samuelitorojas12-arch/Carrito-S.L.26/Pruebas de Funcionamiento/2.jpeg

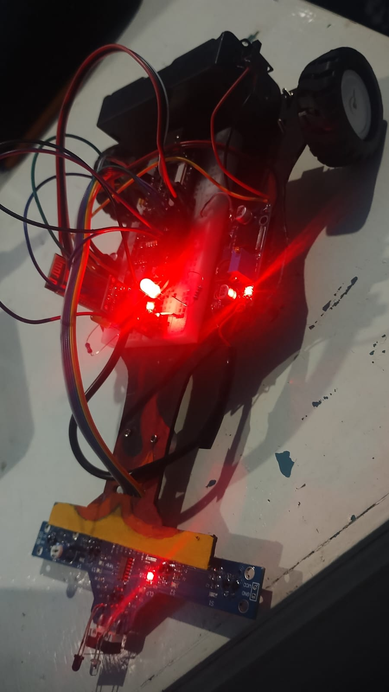
Pruebas de Funcionamiento/2.jpeg
