samuelitorojas12-arch/Carrito-S.L.26/doc/REPORTE_UNIVERSITARIO.md

# Reporte Técnico: Controlador Digital de Seguidor de Línea Competitivo con FPGA Tang Nano 9K
**Curso: Programacion Avanzada / Diseño con FPGAs**  
**Departamento de Ingeniería Electrónica - Universidad Veracruzana**

---

## Resumen
Este informe presenta el diseño, la implementación y la verificación de un controlador digital modular síncrono para un robot móvil seguidor de línea de alto rendimiento, desarrollado para participar en la **“2.ª Carrera de Carritos Seguidores de Línea 2026”**. El proyecto fue posteriormente optimizado y mejorado a partir de observaciones, comentarios y propuestas de mejora realizadas por el docente responsable, con el objetivo de incrementar su funcionalidad, robustez y desempeño general.

El sistema fue implementado en hardware sobre la FPGA **Tang Nano 9K (GW1NR-LV9QN88PC6/I5)** e integra diversas funcionalidades avanzadas, entre las que destacan una estrategia de arranque autónomo mediante sensor de luz (LDR) con inmunidad al ruido, control de velocidad de motores mediante modulación por ancho de pulso (PWM) a 20 kHz y la incorporación de un módulo de comunicación Bluetooth **HC-05**, capaz de transmitir y recibir información para la interacción y supervisión del usuario.

Asimismo, se implementó un algoritmo de recuperación inteligente basado en memoria de dirección, diseñado para permitir que el vehículo retome la trayectoria en caso de pérdida temporal del contraste de la pista. Como medida adicional de seguridad, el sistema incorpora un mecanismo de detención automática de dos segundos ante determinadas condiciones de operación.

La síntesis lógica y el ruteo físico del diseño fueron realizados mediante la herramienta **Gowin EDA**, obteniéndose un resultado final libre de errores y advertencias. Para alcanzar este nivel de estabilidad fue necesario aplicar restricciones temporales mediante archivos **.sdc**, así como resolver conflictos de asignación de voltaje en los bancos lógicos de la FPGA, garantizando así el correcto funcionamiento y la confiabilidad del sistema implementado.

---

## 1. Introducción y Cumplimiento del Reglamento

El diseño de un vehículo robótico seguidor de línea de competencia (modalidad carrera de alcance) requiere maximizar la velocidad promedio en rectas y la estabilidad en curvas, garantizando a su vez el estricto cumplimiento de las normas oficiales establecidas en el reglamento:

1.  **Arranque Autónomo Obligatorio:** El reglamento prohíbe cualquier movimiento del carro antes del destello de la luz LED blanca de inicio. Para cumplir esto, el sistema integra un sensor óptico frontal (fotoresistencia LDR acoplada a un comparador LM393) que actúa como llave de encendido. La FPGA filtra y valida esta señal física en un módulo digital exclusivo para evitar descalificaciones por salidas en falso.
2.  **Dimensiones Máximas (24 cm de largo, 20 cm de ancho):** El chasis de tracción diferencial cuenta con unas dimensiones de $18\text{ cm} \times 14\text{ cm}$, lo que cumple cómodamente con la regla y optimiza el momento de inercia rotacional en curvas cerradas.
3.  **Algoritmo de Recuperación en Pista (Línea Perdida):** Ante salidas totales de la línea negra de 2 cm de ancho, el carro dispone de 10 segundos reglamentarios para reincorporarse de forma autónoma. El controlador de la FPGA memoriza la última corrección válida de los sensores infrarrojos e inicia una rotación de pivote (motores opuestos) en la misma dirección de escape para re-detectar la trayectoria. Si tras 2 segundos de búsqueda no se detecta la pista, el sistema se detiene automáticamente por seguridad.

---

## 2. Arquitectura Electrónica y Modular

### C. Módulo Bluetooth HC-05 (arranque_bt.v)

Este módulo monitorea continuamente los datos válidos recibidos desde el receptor UART. Cuando detecta la recepción del carácter ASCII **'1'** (valor hexadecimal **0x31**), genera y activa la señal **start_flag_bt**, la cual funciona como una bandera de inicio del sistema. Una vez activada, esta señal permanece enclavada (estado lógico alto) de manera indefinida, permitiendo indicar que se ha recibido la orden de arranque. La bandera únicamente puede ser desactivada mediante una señal de **reset**, garantizando así la persistencia del comando de inicio hasta que el sistema sea reiniciado.

```
[Entradas]                            [Núcleo de Procesamiento FPGA]                            [Salidas]
  CLK (52)  -----------------------> [  filtro_arranque  ]                                   
  LDR (33)  ----------------------->      |                                                  
                                          v (start_flag)                                     
  S1...S5   -----------------------> [  seguidor_linea_core ] ----------------------------->  Dirección Motores
  (28...32)                               |                                                   (34 y 35)
                                          v (duty_cycle)                                     
                                     [  controlador_pwm   ] ----------------------------->  Velocidad Motores (PWM)
                                                                                              (10 y 11)
```

### A. Filtro del Sensor de Arranque LDR (`filtro_arranque.v`)
La señal entregada por el comparador LM393 del LDR puede contener oscilaciones y transitorios causados por la luz ambiental o el encendido de flashes en la pista. El módulo de arranque implementa un contador digital de histéresis temporal. Requiere que la entrada `LDR_IN` se mantenga en nivel alto de forma ininterrumpida por al menos 10 ms ($270,000$ ciclos a 27 MHz) antes de activar la bandera `start_flag`. Una vez activada, la señal se enclava de forma irreversible en `1` hasta que ocurra un reset físico de la tarjeta, evitando que las sombras generadas por el propio carro durante la carrera afecten la marcha.

### B. Controlador PWM de Frecuencia Portadora (`controlador_pwm.v`)
El control continuo de velocidad de los micromotores N20 se realiza mediante Modulación por Ancho de Pulso (PWM). El módulo implementa dos generadores de rampa de 8 bits (resolución de 0 a 255). A partir de la frecuencia de reloj del sistema, se introduce un prescaler divisor entre 5 que disminuye la base de tiempos a un periodo de rampa de $48.3\ \mu\text{s}$, lo que equivale a una frecuencia portadora de **20.7 kHz**. Esta frecuencia ultrasónica es ideal para pequeños servomotores y motores DC metálicos: elimina por completo el molesto silbido mecánico audible en los bobinados y reduce de forma significativa las corrientes de rizado y disipación térmica en el chip driver (TB6612FNG).

 ### C. Módulo Bluetooth HC-05 (arranque_bt.v)

Este módulo se encarga de supervisar los datos recibidos y validados por el receptor UART proveniente del módulo Bluetooth HC-05. Cuando detecta la recepción del carácter ASCII **'1'** (código hexadecimal **0x31**), activa la señal **start_flag_bt**, la cual indica el inicio de la operación del sistema. Una vez establecida, esta bandera permanece activa de forma permanente mediante un mecanismo de enclavamiento, evitando que se pierda la orden de arranque. La señal únicamente se restablece a su estado inicial cuando se ejecuta un reinicio (reset) del sistema.

### D. Núcleo de Control y Recuperación (`seguidor_linea_core.v`)
El núcleo implementa la máquina de control de velocidad y sentido de giro, traduciendo los estados de los sensores infrarrojos reflectantes ($S_1$ a $S_5$) en salidas de potencia de acuerdo con la tabla de verdad y la estrategia de control competitiva:
*   **Marcha Recta (`00100`):** Máxima potencia hacia ambos motores (`VEL_MAX = 225`) en sentido directo para recortar distancias en tramos lineales.
*   **Curvas Suaves (`01100` y `00110`):** Se desacelera levemente el motor interno a la curva (`VEL_MED = 150`) mientras el exterior se mantiene a potencia máxima para realizar correcciones sin detener el carro.
*   **Curvas Cerradas (`01000` y `00010`):** El motor interno se frena a velocidad mínima (`VEL_MIN = 70`) para inducir un radio de giro cerrado.
*   **Curvas Críticas / Pivote (`10000` y `00001`):** Para giros de emergencia, el motor interno se invierte físicamente en sentido de retroceso (`VEL_REV = 130`, `dir = 1`) y el exterior se mantiene en avance directo, forzando un giro rápido sobre su propio eje (torque diferencial puro).
*   **Línea Perdida (`00000`):** Se activa un temporizador de seguridad de $54,000,000$ de ciclos (2 segundos). Mientras corre el tiempo, el núcleo consulta el registro `last_direction` y ordena un giro de pivote en el sentido donde vio por última vez la línea para recuperarla de forma inmediata.

---

## 3. Mapa de Pines del Sistema
La siguiente tabla consolida el mapeo físico de los puertos del controlador a la FPGA Tang Nano 9K, utilizando los estándares eléctricos e impedancias requeridos en el archivo `.cst` de restricciones:

| Puerto | Dirección | Pin FPGA | Estándar E/S | Configuración / Pull-mode | Función Física |
|:---|:---:|:---:|:---:|:---:|:---|
| **CLK** | Entrada | 52 | LVCMOS33 | Pull-up Interno | Reloj de Sistema (Oscilador 27 MHz) |
| **RST** | Entrada | 4 | LVCMOS18 | Pull-up Interno | Botón USR_KEY (Reset Activo en Bajo) |
| **LDR_IN** | Entrada | 33 | LVCMOS33 | Ninguno (Floating) | Sensor óptico de arranque autónomo |
| **S1** | Entrada | 28 | LVCMOS33 | Ninguno (Floating) | Sensor Infrarrojo Extremo Izquierdo |
| **S2** | Entrada | 29 | LVCMOS33 | Ninguno (Floating) | Sensor Infrarrojo Izquierdo Central |
| **S3** | Entrada | 30 | LVCMOS33 | Ninguno (Floating) | Sensor Infrarrojo Central |
| **S4** | Entrada | 31 | LVCMOS33 | Ninguno (Floating) | Sensor Infrarrojo Derecho Central |
| **S5** | Entrada | 32 | LVCMOS33 | Ninguno (Floating) | Sensor Infrarrojo Extremo Derecho |
| **M_IZQ** | Salida | 10 | LVCMOS18 | DRIVE = 8mA | Velocidad Motor Izq. (PWM, LED0 Integrado) |
| **M_DER** | Salida | 11 | LVCMOS18 | DRIVE = 8mA | Velocidad Motor Der. (PWM, LED1 Integrado) |
| **M_IZQ_DIR**| Salida | 34 | LVCMOS33 | DRIVE = 8mA | Sentido Motor Izq. (0: FWD, 1: REV) |
| **M_DER_DIR**| Salida | 35 | LVCMOS33 | DRIVE = 8mA | Sentido Motor Der. (0: FWD, 1: REV) |
| **LED_REC** | Salida | 13 | LVCMOS18 | DRIVE = 8mA | LED Indicador Recto (LED2 Integrado) |
| **LED_IZQ** | Salida | 14 | LVCMOS18 | DRIVE = 8mA | LED Indicador Giro Izq. (LED3 Integrado) |
| **LED_DER** | Salida | 15 | LVCMOS18 | DRIVE = 8mA | LED Indicador Giro Der. (LED4 Integrado) |
| **LED_STOP**| Salida | 16 | LVCMOS18 | DRIVE = 8mA | LED Indicador Parada (LED5 Integrado) |
| **MOD_BLU**| Salida | 27 | LVCMOS33 | Ninguno (Floating)| Modulo Bluetooth |
| **LED_RED**| Salida | 25 | LVCMOS33 | Ninguno (Floating) | LED Indicador Parada (LED Fisico) |
| **LED_GREEN**| Salida | 26 | LVCMOS33 | Ninguno (Floating) | LED Indicador Movimiento (LED Fisico) | 

*Nota sobre voltajes de banco:* Todos los pines pertenecientes al Banco 3 (pines 4, 10, 11, 13, 14, 15 y 16) están configurados con el estándar `LVCMOS18` debido a la restricción física de hardware de la Tang Nano 9K (VCCIO hardwired a 1.8V para la PSRAM), evitando fallas durante la fase de Place & Route.

---

## 4. Plan de Pruebas y Resultados de Simulación
La verificación funcional del controlador se realizó por medio de simulación RTL utilizando el testbench `seguidor_linea_tb.v`. Los parámetros de tiempo se acortaron proporcionalmente mediante directivas `defparam` en el simulador para realizar un barrido rápido de las pruebas:

1.  **Arranque Bloqueado (0 a 100 ns):** Se simula el encendido con sensores activos (`S3=1`) pero LDR en bajo (`LDR_IN=0`). Se confirma que las velocidades de los motores permanecen en cero y que `LED_STOP` se mantiene encendido, demostrando la obediencia al semáforo de salida.
2.  **Rechazo de Transitorio (100 ns a 300 ns):** Se aplica un pulso corto de luz en el LDR. El sistema lo ignora al no cumplir la histéresis temporal.
3.  **Disparo por Luz Estable (300 ns a 500 ns):** Se enciende `LDR_IN` de forma continua. La bandera `start_flag` cambia a `1` y habilita de forma permanente las salidas del puente H.
4.  **Verificación de Modulación PWM y Marcha Recta:** Con la entrada `00100`, los motores giran en sentido de avance (`M_IZQ_DIR=0`, `M_DER_DIR=0`) con una modulación del ciclo de trabajo en alto de la señal PWM correspondiente a `VEL_MAX`.
5.  **Prueba de Giro de Pivote (Giro Fuerte):** Con la entrada `00001` (desvío extremo derecho), el motor izquierdo se mantiene en avance directo, mientras el motor derecho invierte su sentido de rotación (`M_DER_DIR=1`) a velocidad controlada (`VEL_REV`), validando la torsión diferencial de pivote.
6.  **Memoria ante Pérdida y Detención Segura (Línea Perdida):** Al pasar abruptamente de giro derecho a la lectura `00000`, la FPGA mantiene el pivote derecho por inercia para recapturar la línea. Si la condición persiste durante el intervalo del timer, los motores pasan a `0` y la bandera `stop_timeout` detiene el carro, cumpliendo el límite seguro del reglamento.

---

## 5. Conclusiones del Diseño

1.  **Garantía de Cero Falsos Arranques:** El módulo de histéresis digital del LDR provee inmunidad completa frente a interferencias ópticas de la luz ambiental del auditorio, asegurando que el carro comience su marcha únicamente con la activación del semáforo LED de inicio.
2.  **Maniobrabilidad con Pivote Dinámico:** El uso de rotación por inversión física de motores en curvas extremas y durante la búsqueda en línea perdida elimina el derrape por inercia lineal, logrando trayectorias más cerradas y rápidas que los algoritmos tradicionales de freno pasivo.
3.  **Eficiencia y Confiabilidad Eléctrica:** El ajuste del estándar de voltaje a `LVCMOS18` en los puertos del Banco 3 respeta las limitaciones eléctricas del hardware real del Tang Nano 9K, eliminando el riesgo de sobrecalentamiento en los buffers de salida y garantizando un Place & Route limpio con **0 errores y 0 warnings** de compilación.
4.  **Baja Latencia de Procesamiento:** Al implementarse en hardware digital paralelo sobre la FPGA, el tiempo transcurrido desde que un sensor detecta el cambio de contraste hasta que el driver del motor recibe la modulación del PWM es menor a **40 nanosegundos**, una respuesta miles de veces más rápida que cualquier controlador basado en microcontrolador por software, maximizando las posibilidades de alcance competitivo.
